netube99/CH573_KIT/README.md

# CH573_KIT
CH573F 开发板

* USB/锂电池供电，最高5.5V输入
* 板载功耗检测端口（默认短路），可检测板工作电压电流
* 串口USB/主从机USB/温度传感器/DEBUG端口

* 拓展电路可通过跳线帽短断路，方便低功耗实验，所有IO均已引出

TODO

* 改善射频传输线设计
* 去掉多余的保险丝

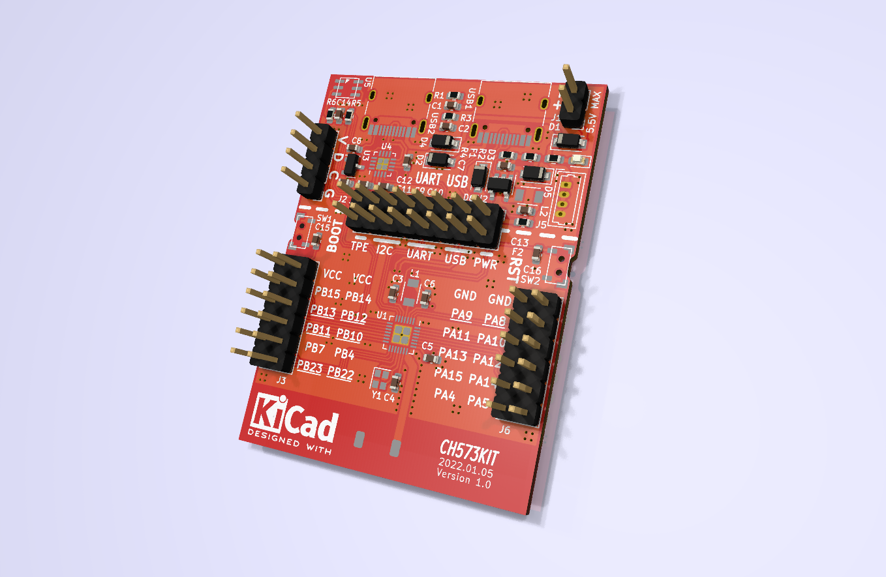
[picture p1: Document/CH573KIT_3D.png]


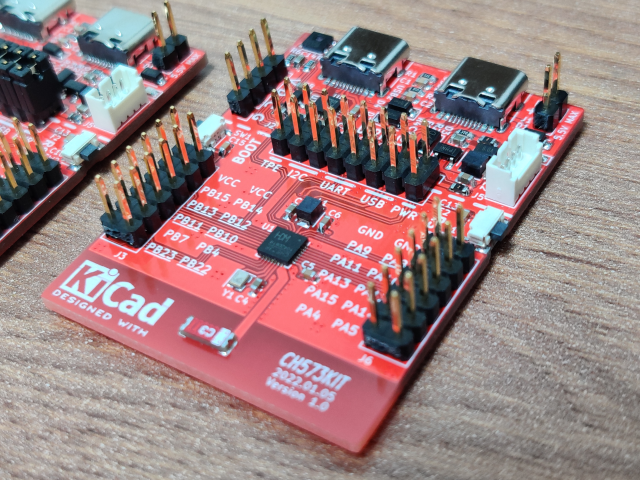
[picture p2: Document/CH573KIT.png]
