netube99/CH573_KIT/CH573_KIT/CH573_KIT.pdf

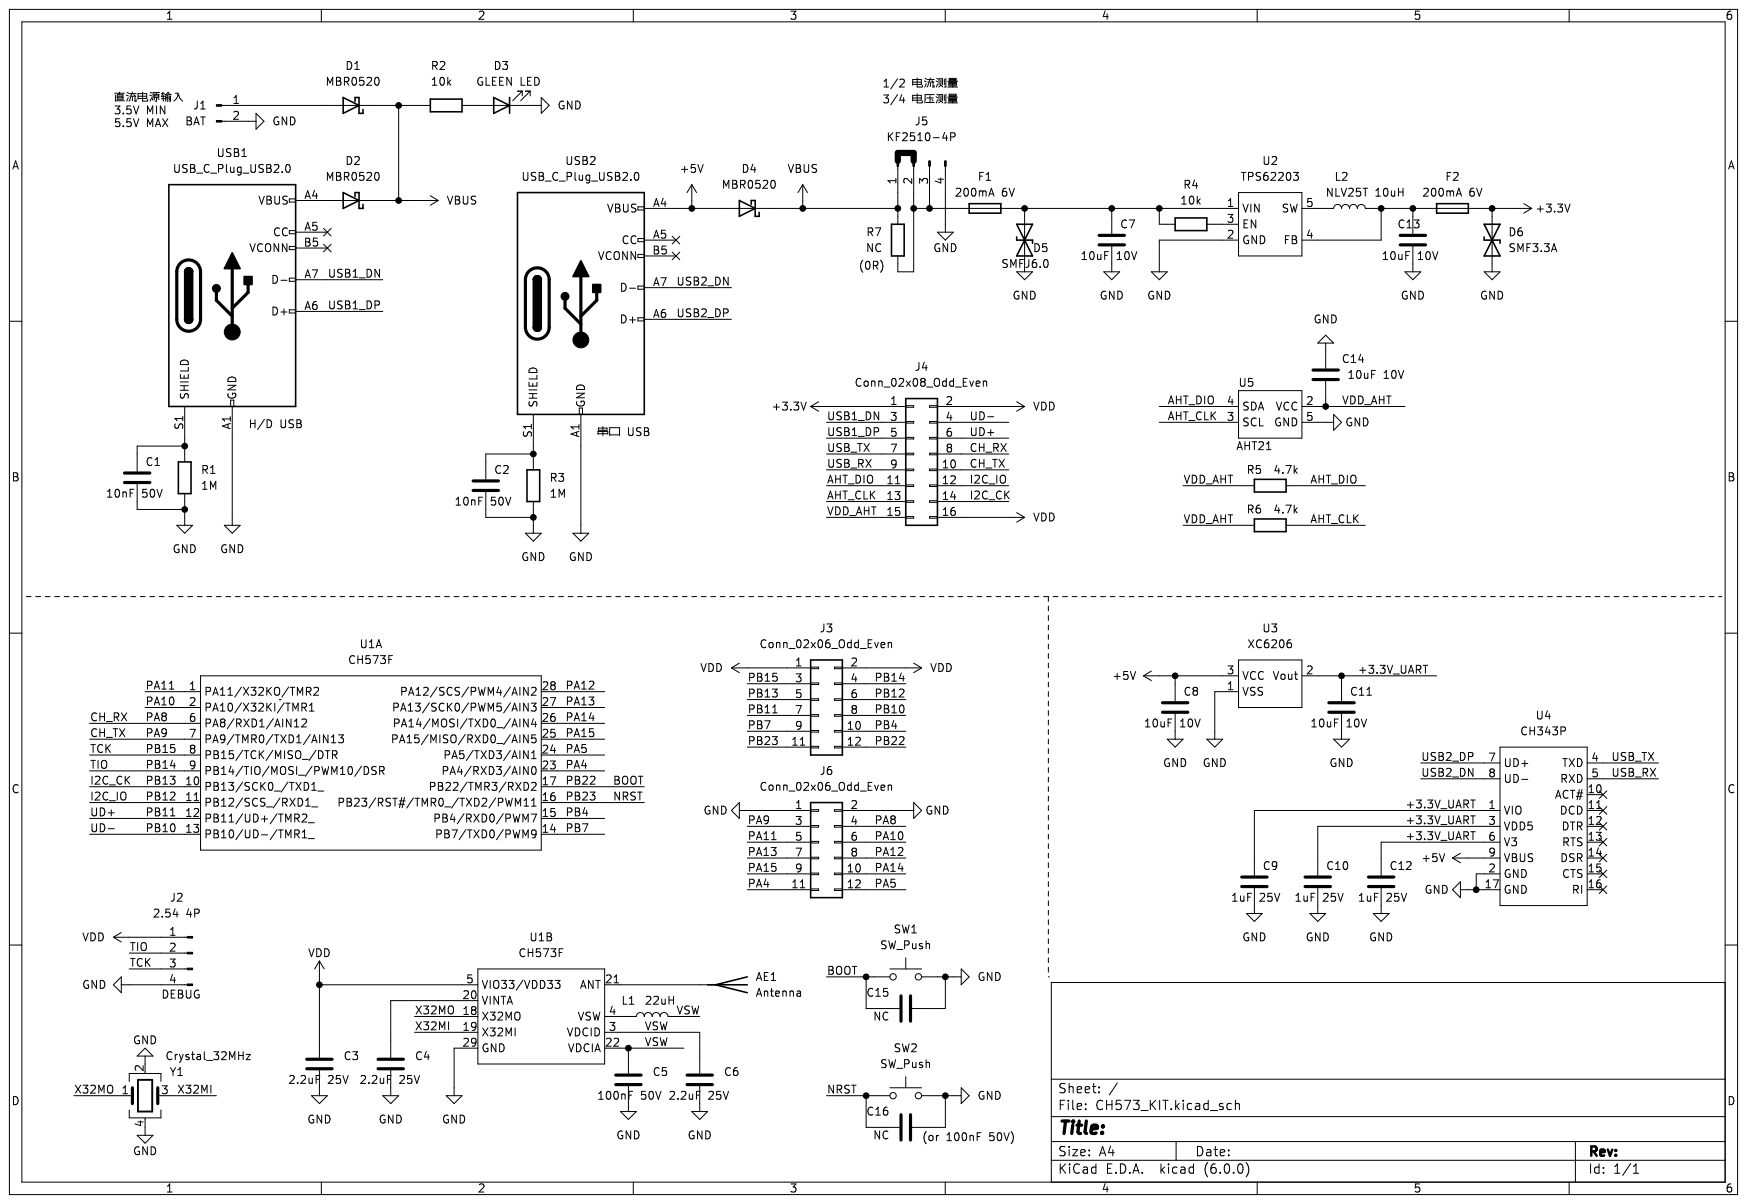
[picture p3: page 1]
